psychogenic/caravel-mvp/caravel-mvp.kicad_sch

## KiCad design caravel-mvp.kicad_sch (2023-10-27)

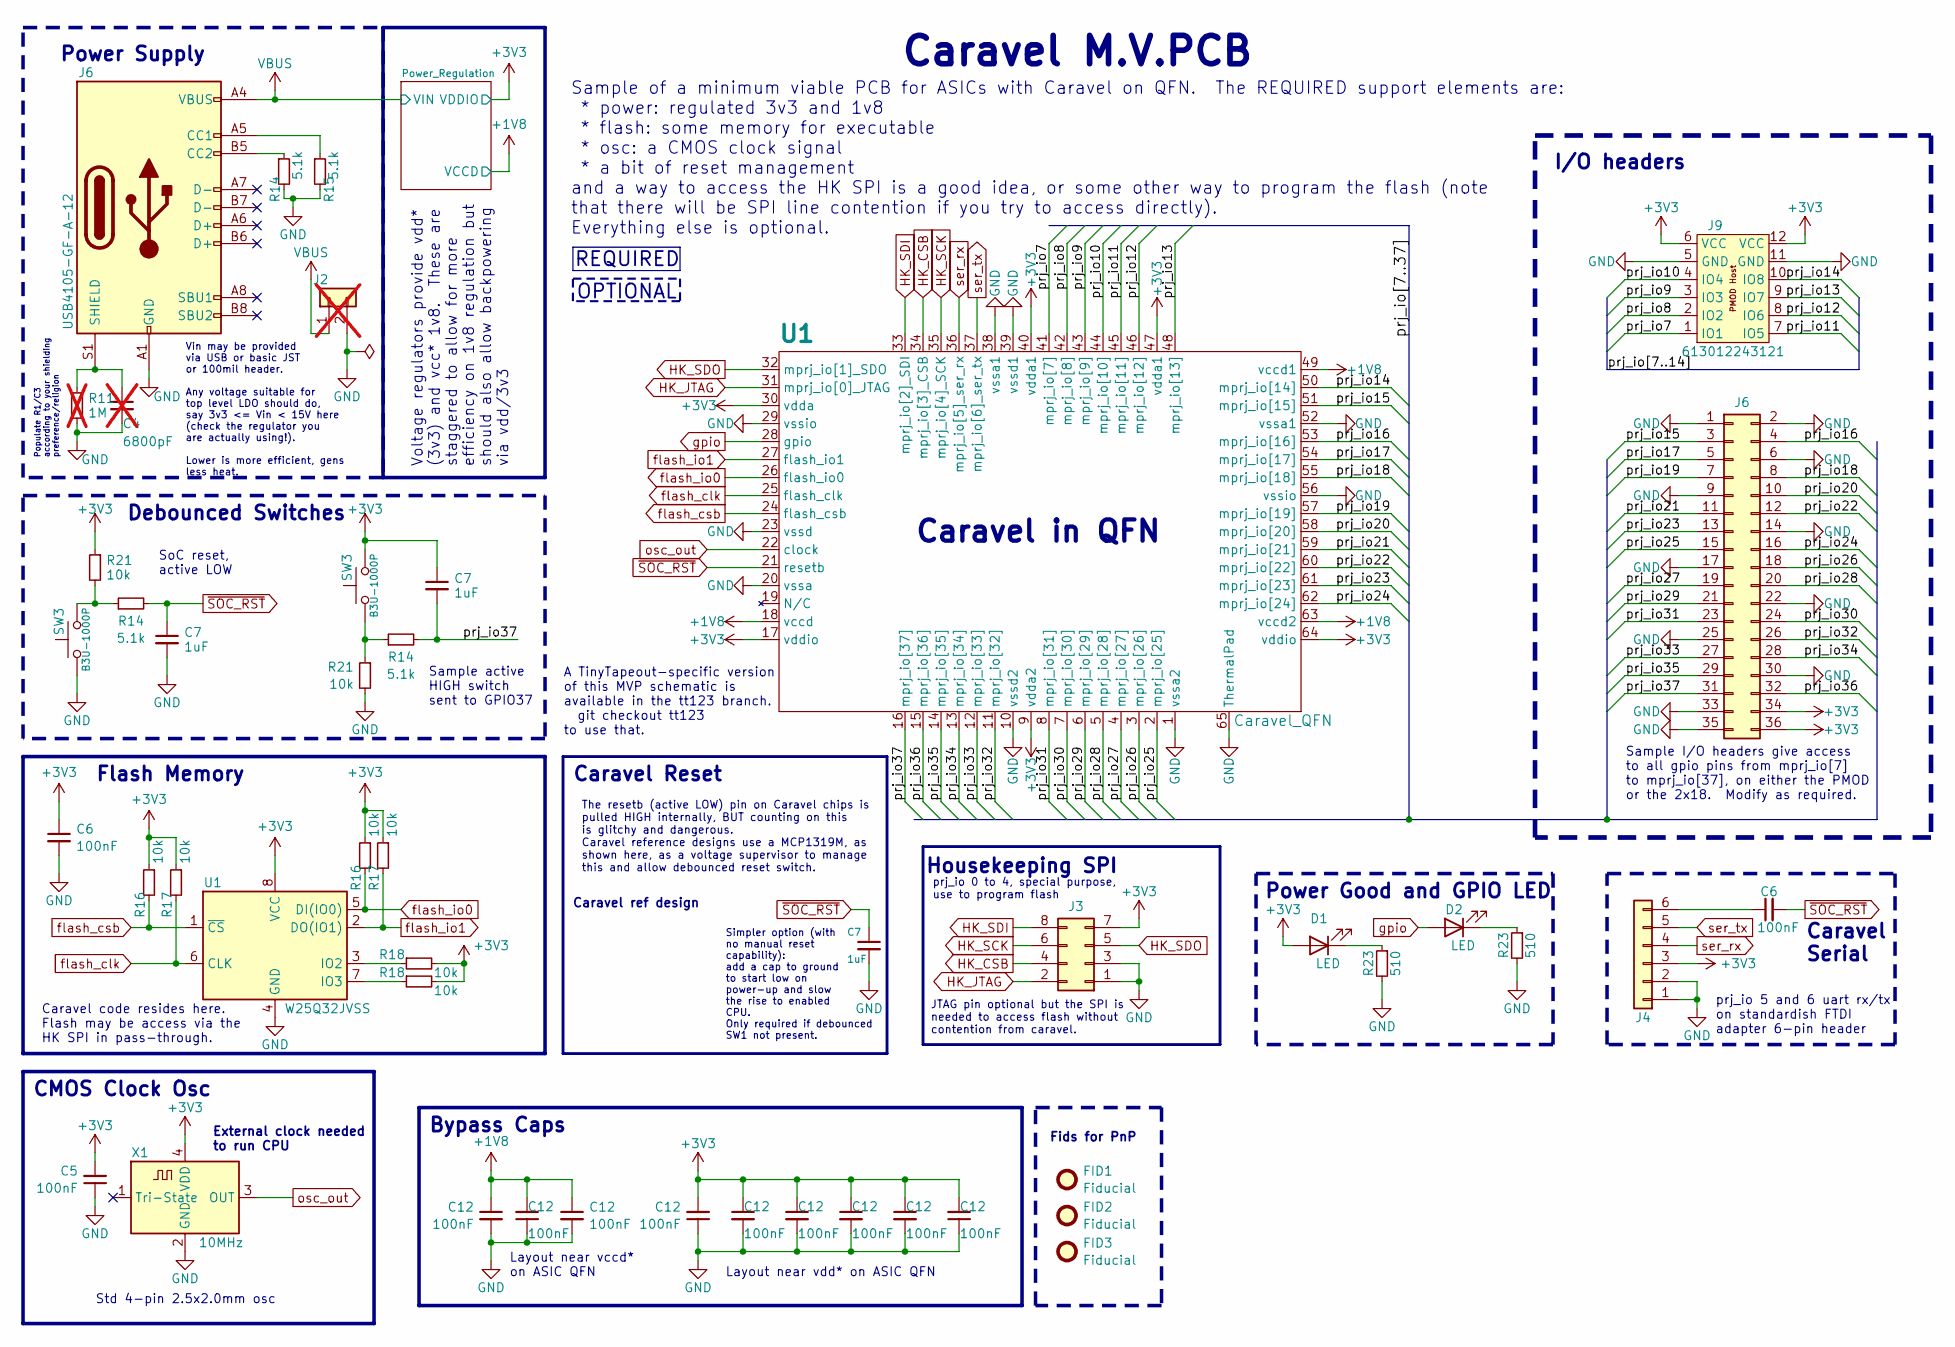
[picture p1: schematic caravel-mvp.kicad_sch]

Parts:
C4: 6800pF; C_0603_1608Metric; not fitted
C5, C6, C12: 100nF; C_0603_1608Metric
C7: 1uF; C_0603_1608Metric
D1, D2: LED; LED_0603_1608Metric
FID1, FID2, FID3: Fiducial; Fiducial_1mm_Mask2mm
J2: Conn_01x02; JST_PH_B2B-PH-K_1x02_P2.00mm_Vertical; not fitted
J3: Conn_02x04_Odd_Even; PinHeader_2x04_P2.54mm_Vertical
J4: Conn_01x06; PinHeader_1x06_P2.54mm_Vertical
J6: Conn_02x18_Odd_Even; PinHeader_2x18_P2.54mm_Vertical
J9: 613012243121; PinSocket_2x06_P2.54mm_PMODHost1A; MPN 613012243121
R11: 1M; R_0603_1608Metric; not fitted
R14, R15: 5.1k; R_0603_1608Metric
R16, R17, R18, R21: 10k; R_0603_1608Metric
R23: 510; R_0603_1608Metric; MPN RC0603FR-07510RL
SW3: B3U-1000P; SW_SPST_B3U-1000P; MPN B3U-1000P
U1: W25Q32JVSS; SOIC-8_5.23x5.23mm_P1.27mm; MPN W25Q32JVSSIQ
X1: 10MHz; Oscillator_SMD_ECS_2520MV-xxx-xx-4Pin_2.5x2.0mm; MPN ECS-2520MVLC-100-CN-TR

Connections:
+1V8: C12.1, C12.2, U1.18 (vccd), U1.49 (vccd1), U1.63 (vccd2)
+3V3: C5.2, C6.1, C7.1, C12.1, C12.2, D1.2 (A), J3.7, J4.3, J6.34, J6.36, J9.6 (VCC), J9.12 (VCC), R16.1, R17.1, R18.2, R21.1, SW3.2, U1.8 (mprj_io[31]), U1.9 (vdda2), U1.17 (vddio), U1.30 (vdda), U1.40 (vdda1), U1.47 (vdda1), U1.64 (vddio), X1.4 (VDD)
GND: C4.2, C5.1, C6.2, C7.2, C12.1, C12.2, J2.2, J3.1, J3.3, J4.1, J4.2, J6.1, J6.2, J6.6, J6.9, J6.14, J6.17, J6.22, J6.25, J6.30, J6.33, J6.35, J6.A1 (GND), J6.A12 (GND), J6.B1 (GND), J6.B12 (GND), J9.5 (GND), J9.11 (GND), R11.2, R14.2, R15.2, R21.2, R23.2, SW3.1, U1.1 (vssa2), U1.4 (mprj_io[27]), U1.10 (vssd2), U1.20 (vssa), U1.23 (vssd), U1.29 (vssio), U1.38 (vssa1), U1.39 (vssd1), U1.52 (vssa1), U1.56 (vssio), U1.65 (ThermalPad), X1.2 (GND)
HK_CSB: J3.4, U1.34 (mprj_io[3]_CSB)
HK_JTAG: J3.2, U1.31 (mprj_io[0]_JTAG)
HK_SCK: J3.6, U1.35 (mprj_io[4]_SCK)
HK_SDI: J3.8, U1.33 (mprj_io[2]_SDI)
HK_SDO: J3.5, U1.32 (mprj_io[1]_SDO)
unnamed: C4.1, J6.S1 (SHIELD), R11.1
unnamed: C6.1, J4.6
unnamed: D1.1 (K), R23.1
unnamed: D2.1 (K), R23.1
unnamed: J6.A5 (CC1), R15.1
unnamed: J6.B5 (CC2), R14.1
unnamed: R14.1, R21.1, R21.2, SW3.1, SW3.2
unnamed: R18.1, U1.3 (mprj_io[26]), U1.7 (mprj_io[30])
VBUS: J2.1, J6.A4 (VBUS), J6.A9 (VBUS), J6.B4 (VBUS), J6.B9 (VBUS)
flash_clk: R17.2, U1.6 (mprj_io[29]), U1.25 (flash_clk)
flash_csb: R16.2, U1.1 (vssa2), U1.24 (flash_csb)
flash_io0: R16.2, U1.5 (mprj_io[28]), U1.26 (flash_io0)
flash_io1: R17.2, U1.2 (mprj_io[25]), U1.27 (flash_io1)
gpio: D2.2 (A), U1.28 (gpio)
osc_out: U1.22 (clock), X1.3 (OUT)
prj_io7: J9.1 (IO1), U1.41 (mprj_io[7])
prj_io8: J9.2 (IO2), U1.42 (mprj_io[8])
prj_io9: J9.3 (IO3), U1.43 (mprj_io[9])
prj_io10: J9.4 (IO4), U1.44 (mprj_io[10])
prj_io11: J9.7 (IO5), U1.45 (mprj_io[11])
prj_io12: J9.8 (IO6), U1.46 (mprj_io[12])
prj_io13: J9.9 (IO7), U1.48 (mprj_io[13])
prj_io14: J9.10 (IO8), U1.50 (mprj_io[14])
prj_io15: J6.3, U1.51 (mprj_io[15])
prj_io16: J6.4, U1.53 (mprj_io[16])
prj_io17: J6.5, U1.54 (mprj_io[17])
prj_io18: J6.8, U1.55 (mprj_io[18])
prj_io19: J6.7, U1.57 (mprj_io[19])
prj_io20: J6.10, U1.58 (mprj_io[20])
prj_io21: J6.11, U1.59 (mprj_io[21])
prj_io22: J6.12, U1.60 (mprj_io[22])
prj_io23: J6.13, U1.61 (mprj_io[23])
prj_io24: J6.16, U1.62 (mprj_io[24])
prj_io25: J6.15, U1.2 (mprj_io[25])
prj_io26: J6.18, U1.3 (mprj_io[26])
prj_io27: J6.19, U1.4 (mprj_io[27])
prj_io28: J6.20, U1.5 (mprj_io[28])
prj_io29: J6.21, U1.6 (mprj_io[29])
prj_io30: J6.24, U1.7 (mprj_io[30])
prj_io31: J6.23, U1.8 (mprj_io[31])
prj_io32: J6.26, U1.11 (mprj_io[32])
prj_io33: J6.27, U1.12 (mprj_io[33])
prj_io34: J6.28, U1.13 (mprj_io[34])
prj_io35: J6.29, U1.14 (mprj_io[35])
prj_io36: J6.32, U1.15 (mprj_io[36])
prj_io37: C7.2, J6.31, R14.2, U1.16 (mprj_io[37])
ser_rx: J4.4, U1.36 (mprj_io[5]_ser_rx)
ser_tx: J4.5, U1.37 (mprj_io[6]_ser_tx)
~SOC_RST: C6.2, C7.1, R14.2, U1.21 (resetb)

Notes on the sheet:
Caravel Serial
Caravel ref design
Caravel in QFN
CMOS Clock Osc
SoC reset, active LOW
Voltage regulators provide vdd* (3v3) and vcc* 1v8. These are staggered to allow for more efficiency on 1v8 regulation but should also allow backpowering via vdd/3v3
Sample active HIGH switch sent to GPIO37
Power Supply
Fids for PnP
Layout near vdd* on ASIC QFN
Vin may be provided via USB or basic JST or 100mil header. Any voltage suitable for top level LDO should do, say 3v3 <= Vin < 15V here (check the regulator you are actually using!). Lower is more efficient, gens less heat.
OPTIONAL
I/O headers
JTAG pin optional but the SPI is needed to access flash without contention from caravel.
Populate R1/C3 according to your shielding preference/religion
Power Good and GPIO LED
Sample of a minimum viable PCB for ASICs with Caravel on QFN. The REQUIRED support elements are: * power: regulated 3v3 and 1v8 * flash: some memory for executable * osc: a CMOS clock signal * a bit of reset management and a way to access the HK SPI is a good idea, or some other way to program the 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
Debounced Switches
prj_io 0 to 4, special purpose, use to program flash
Caravel code resides here. Flash may be access via the HK SPI in pass-through.
Bypass Caps
External clock needed to run CPU
The resetb (active LOW) pin on Caravel chips is pulled HIGH internally, BUT counting on this is glitchy and dangerous. Caravel reference designs use a MCP1319M, as shown here, as a voltage supervisor to manage this and allow debounced reset switch.
Sample I/O headers give access to all gpio pins from mprj_io[7] to mprj_io[37], on either the PMOD or the 2x18. Modify as required.
Flash Memory
REQUIRED
prj_io 5 and 6 uart rx/tx on standardish FTDI adapter 6-pin header
A TinyTapeout-specific version of this MVP schematic is available in the tt123 branch. git checkout tt123 to use that.
Std 4-pin 2.5x2.0mm osc
Housekeeping SPI
Simpler option (with no manual reset capability): add a cap to ground to start low on power-up and slow the rise to enabled CPU. Only required if debounced SW1 not present.
Caravel Reset
Layout near vccd* on ASIC QFN
Caravel M.V.PCB
