psychogenic/caravel-mvp/(notices)

Notices in the files:
caravel-mvp.kicad_sch:
(C) 2023 Pat Deegan
